scott-whitworth/bancroft_temperature_control/supplementaryData/2021_diagnostic_data/README.md

# Diagnostic Data
Collected summer of 2021 to capture the performance metrics of the system.  

### Heating profiles for full tanks
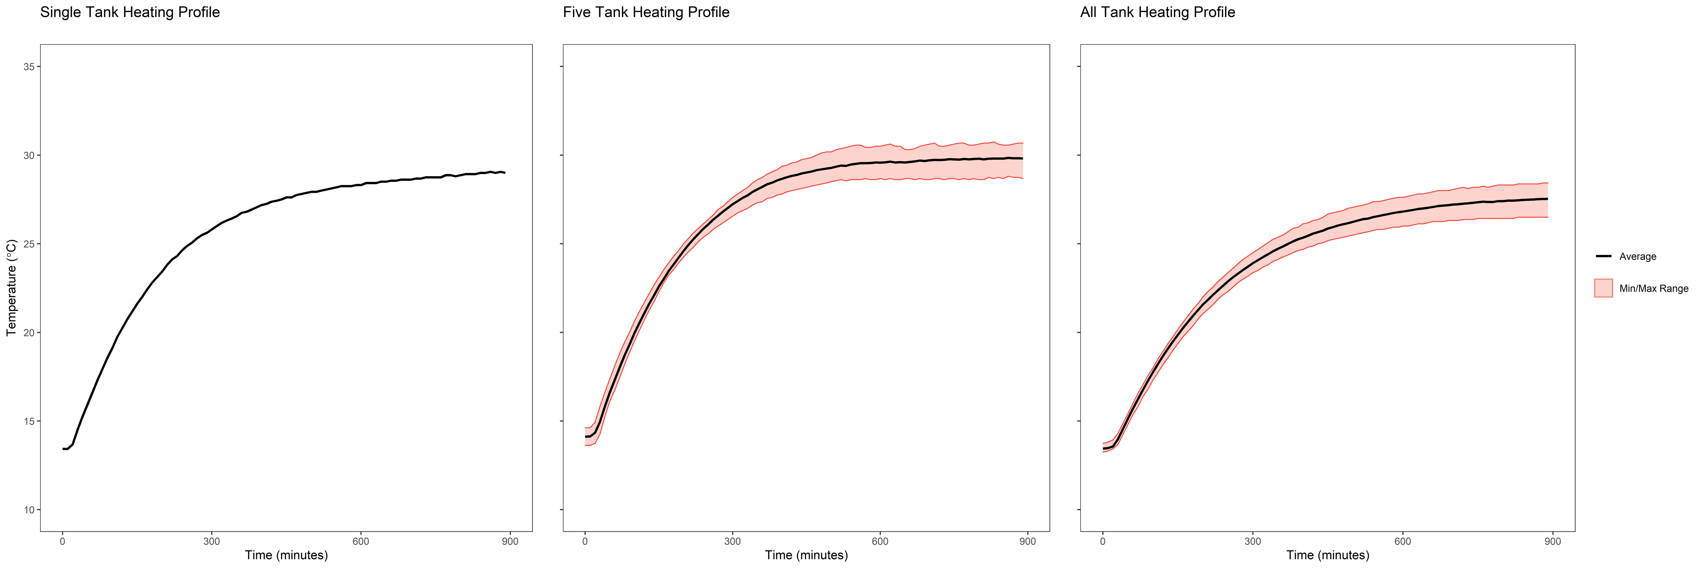
[picture p2: supplementaryData/2021_diagnostic_data/plots/mega_fullTanks__all.png]
ThreeGroup_plot_fullWater

### Heating profiles for half tanks
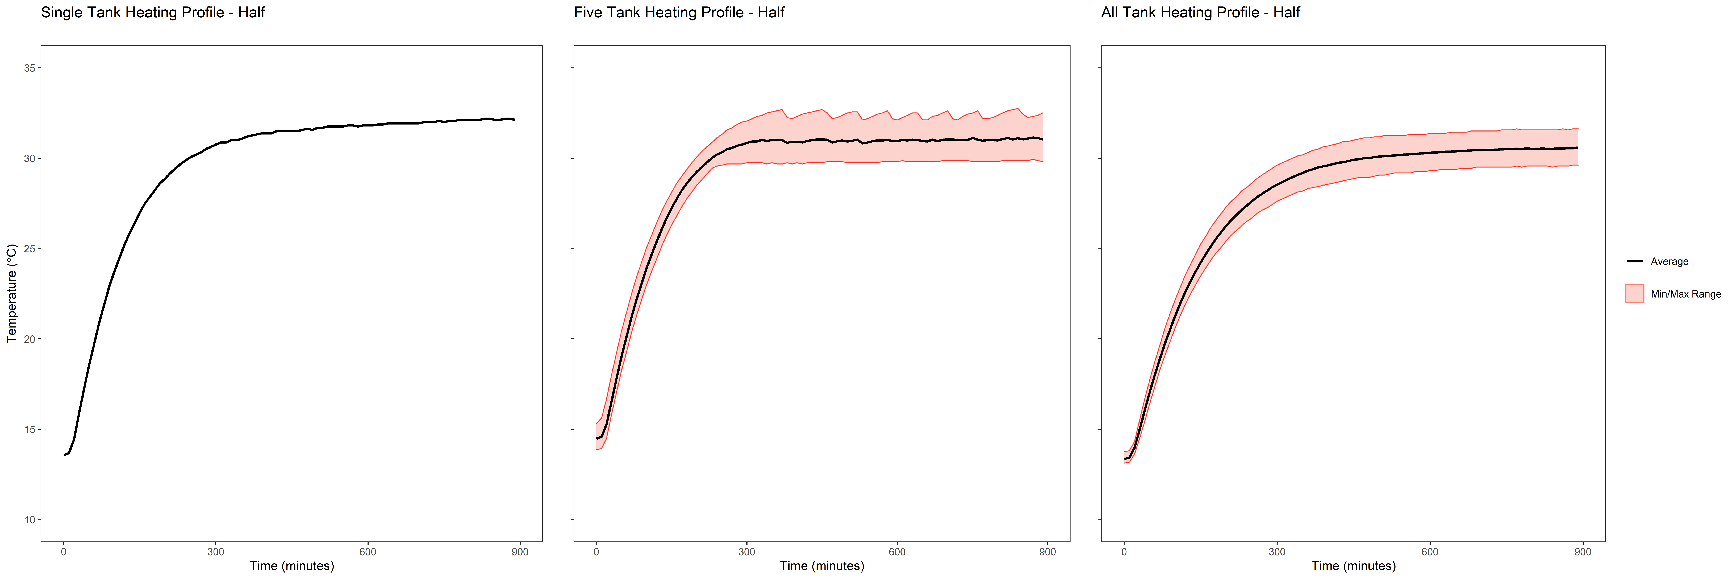
[picture p3: supplementaryData/2021_diagnostic_data/plots/mega_halfTanks__all.png]
ThreeGroup_plot_halfWater
 

## Setup
Each of these data collections were performed on the same 9.4L tanks over the course of two weeks. The goal was to capture approximate performance of the heating system looking at the heating performance when one, five or all nine tanks were heating, as well as the cooling performance. Heating refers to a set temp of 40 degrees C, cooling refers to settling down to the room's ambient (14 degrees C).

In place of using the full system infrastructure, only one Raspberry Pi / Arduino pair was used, without the need to interface with the main control node (Shia). This singular control pair utilized the `peanut_butter_falcon.py` script to collect the data.

Nine tanks were setup in a representative layout, three side by side on each shelf of the rack. There may be some interesting thermal interactions between the tanks. Tanks on a given shelf were spaced by about 2-4 inches separating on their longest side. This means the 'middle' tank was surrounded above, bellow and on each of its larger surface area sides, leaving only the smallest surfaces exposed. This potential thermal interaction can be seen in the individual tanks in `full_one_c2h`.

Tank layout:  

    -------------------------------
    | Tank 73 | Tank 74 | Tank 75 |
    -------------------------------
    | Tank 76 | Tank 77 | Tank 78 |
    -------------------------------
    | Tank 79 | Tank 80 | Tank 81 |
    -------------------------------

## Performance Runs
As the normal experimental set up of the system often modulates the water level in the tanks to represent hydroperiod these performance collections were performed with tanks at both full water levels (~9.4L) as well as half-water levels. As might be expected, the half full tanks heated up faster.  

Another important factor in the performance was the duty cycling of the heaters to limit peak power. When all 9 heaters were 'turned on' the control arduino would apply a sliding window to make sure that only 5 heaters were on at a given time. This means that the per-tank performance is impacted depending on if one tank is heating up, up to five tanks are heating up, or all nine tanks are heating up.

### Full Water Level

| Run | Location | Plot |
|-----|---|---|
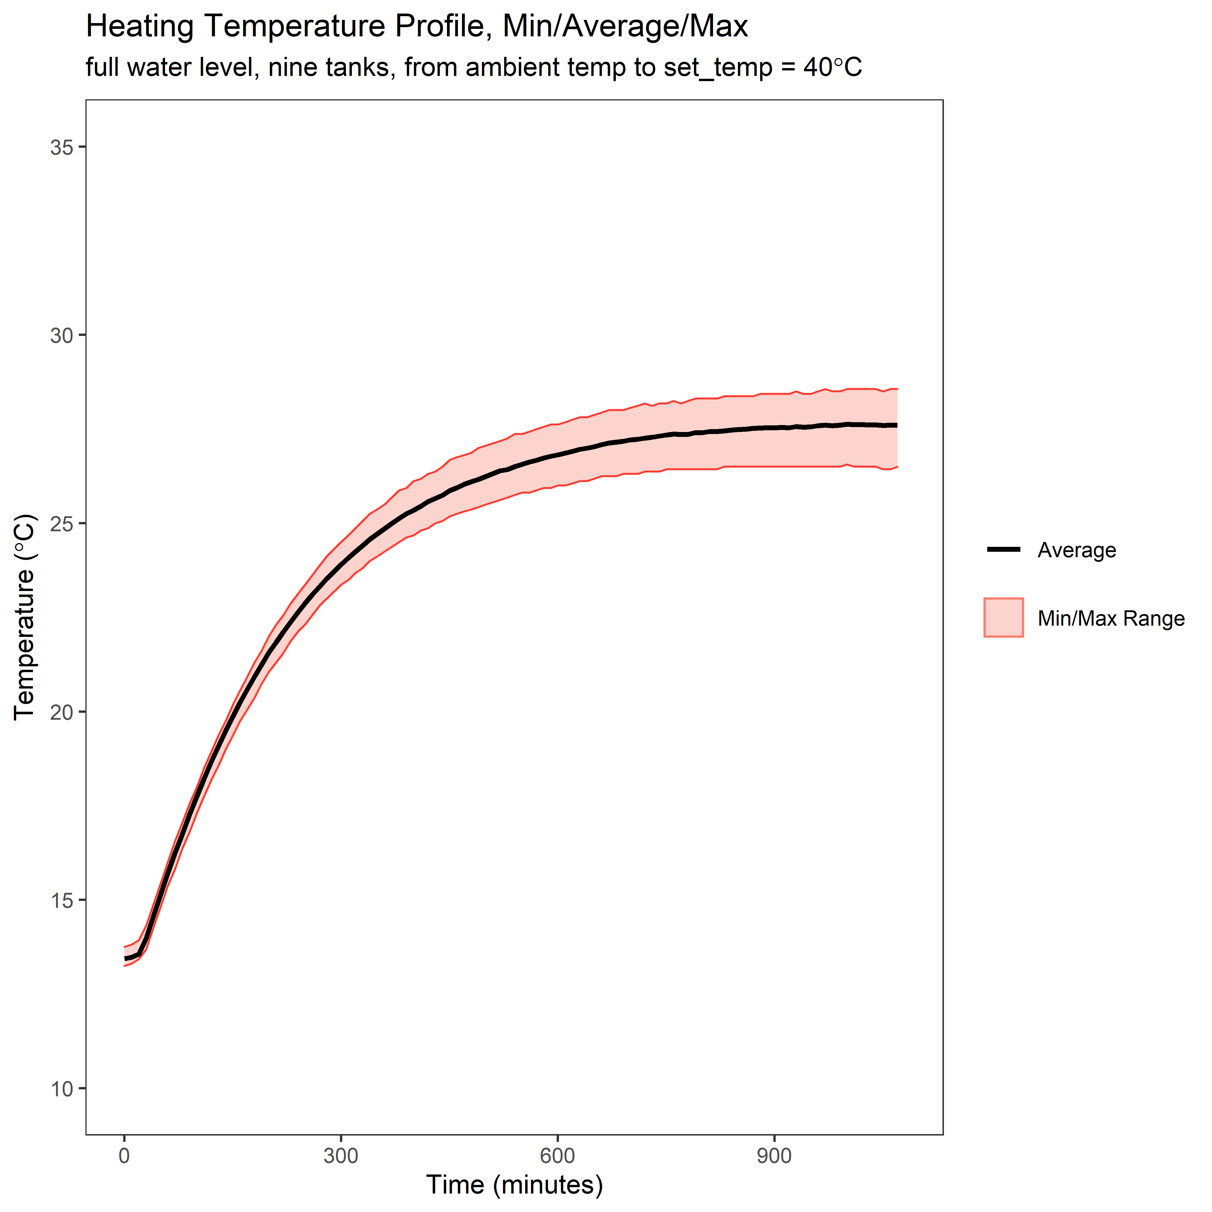
[picture p4: supplementaryData/2021_diagnostic_data/plots/full_all_c2h/full_all_c2h_stat_profile.png]
FullWater_All_Heating
| All Heating | `./plots/full_all_c2h/` |  |
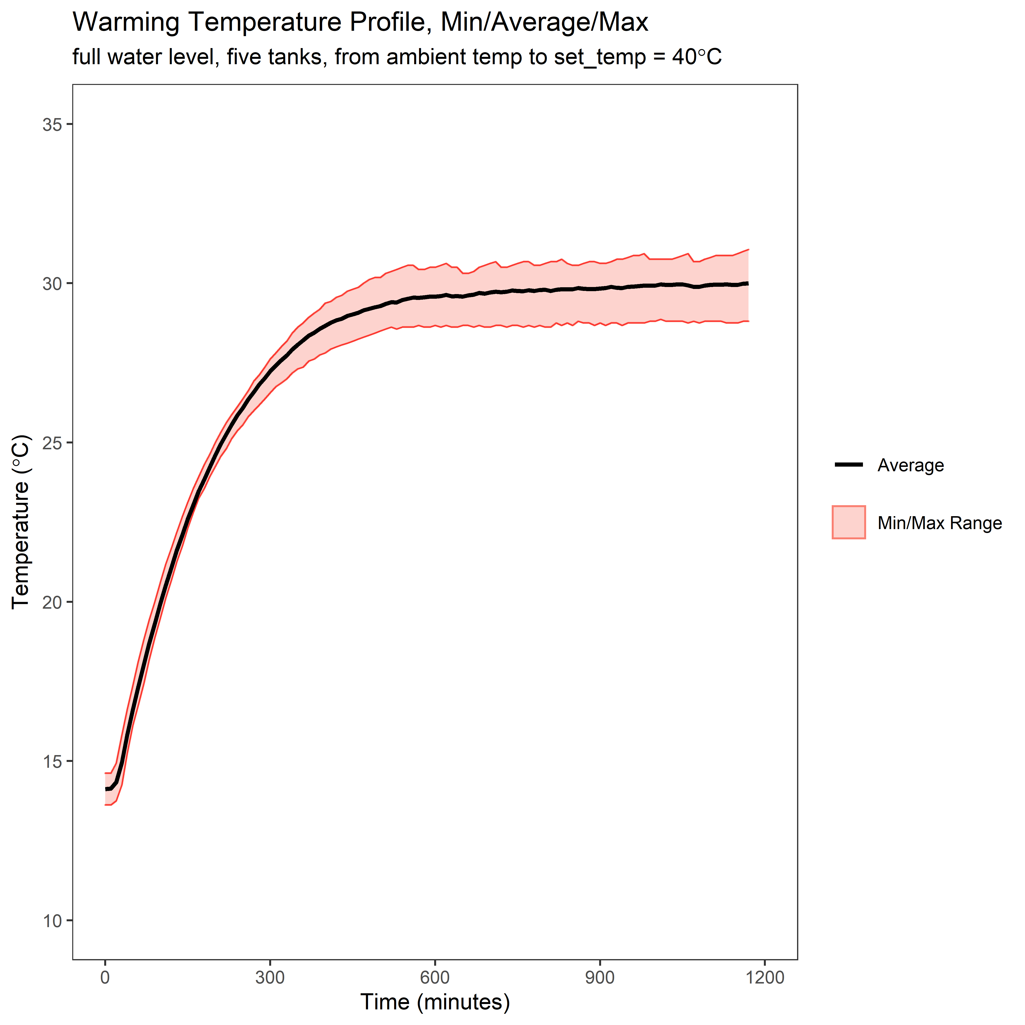
[picture p5: supplementaryData/2021_diagnostic_data/plots/full_five_c2h/full_five_c2h_stat_profile.png]
FullWater_Five_Heating
| Five Heating | `./plots/full_five_c2h/` |  |
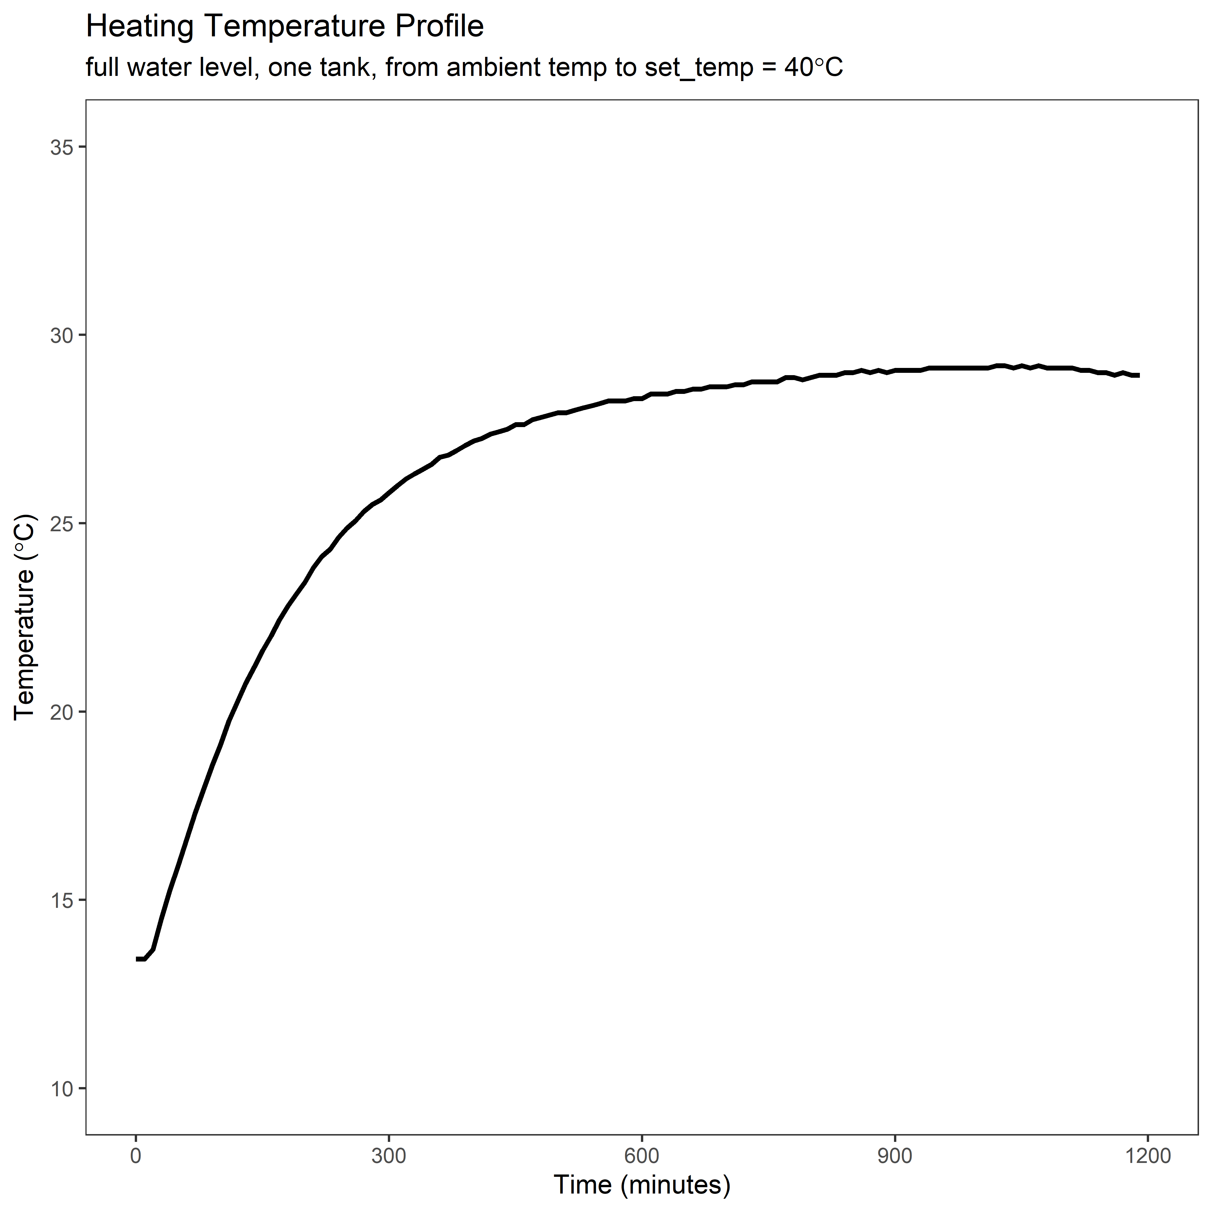
[picture p6: supplementaryData/2021_diagnostic_data/plots/full_one_c2h/full_one_c2h_stat_profile.png]
FullWater_one_Heating
| One Heating | `./plots/full_one_c2h/` |  |
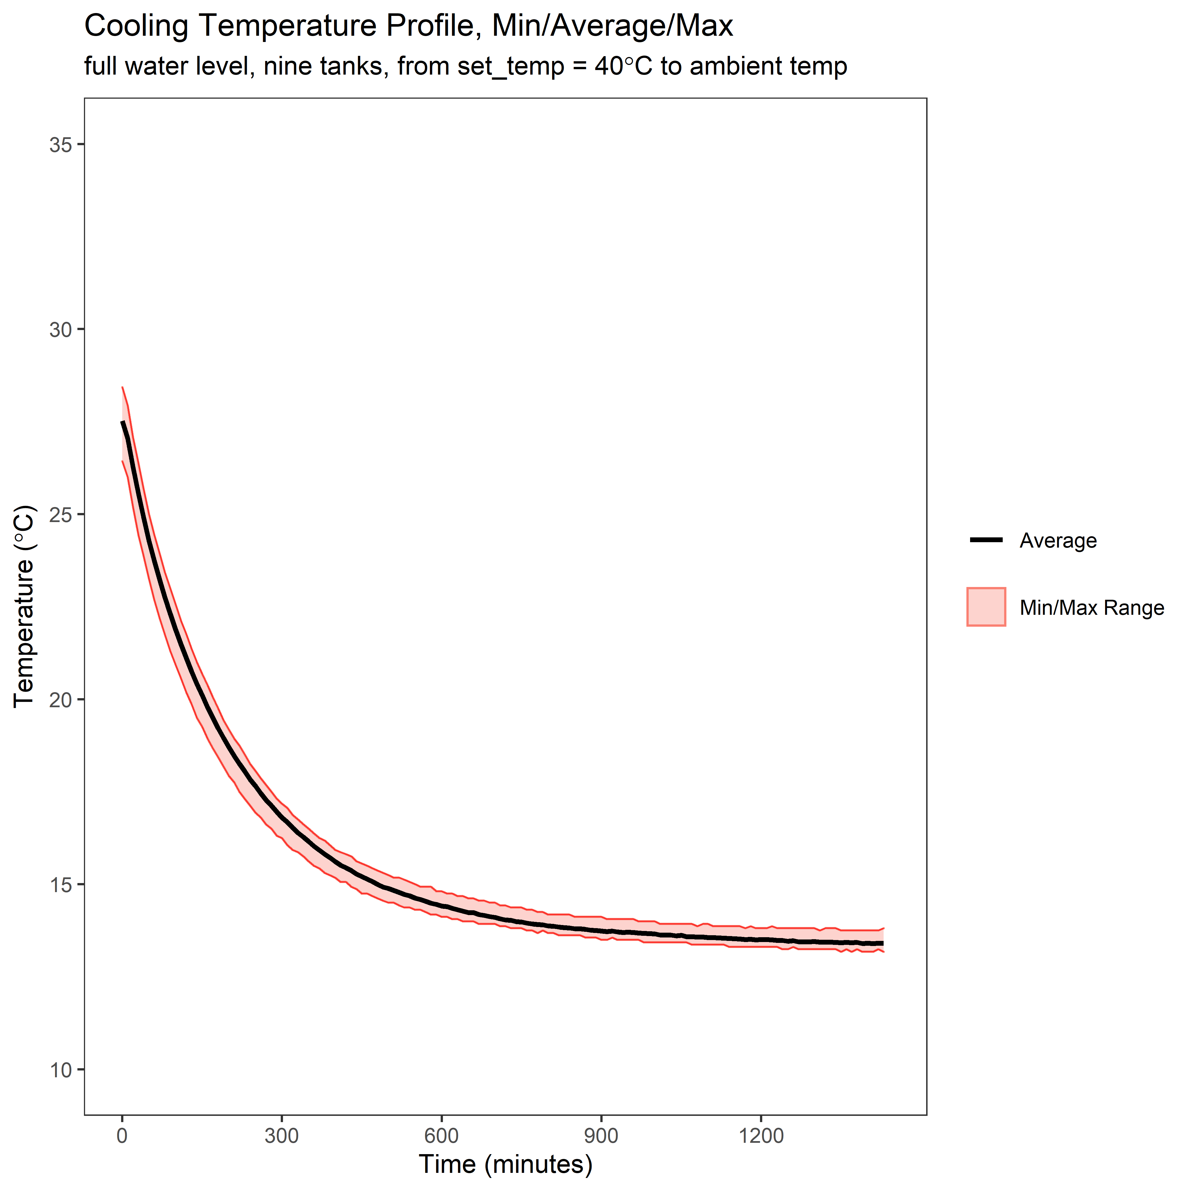
[picture p7: supplementaryData/2021_diagnostic_data/plots/full_all_h2c/full_all_h2c_stat_profile.png]
FullWater_all_Cooling
| All Cooling | `./plots/full_all_h2c/` |  |

### Half Water Level
| Run | Location | Plot |
|-----|---|---|
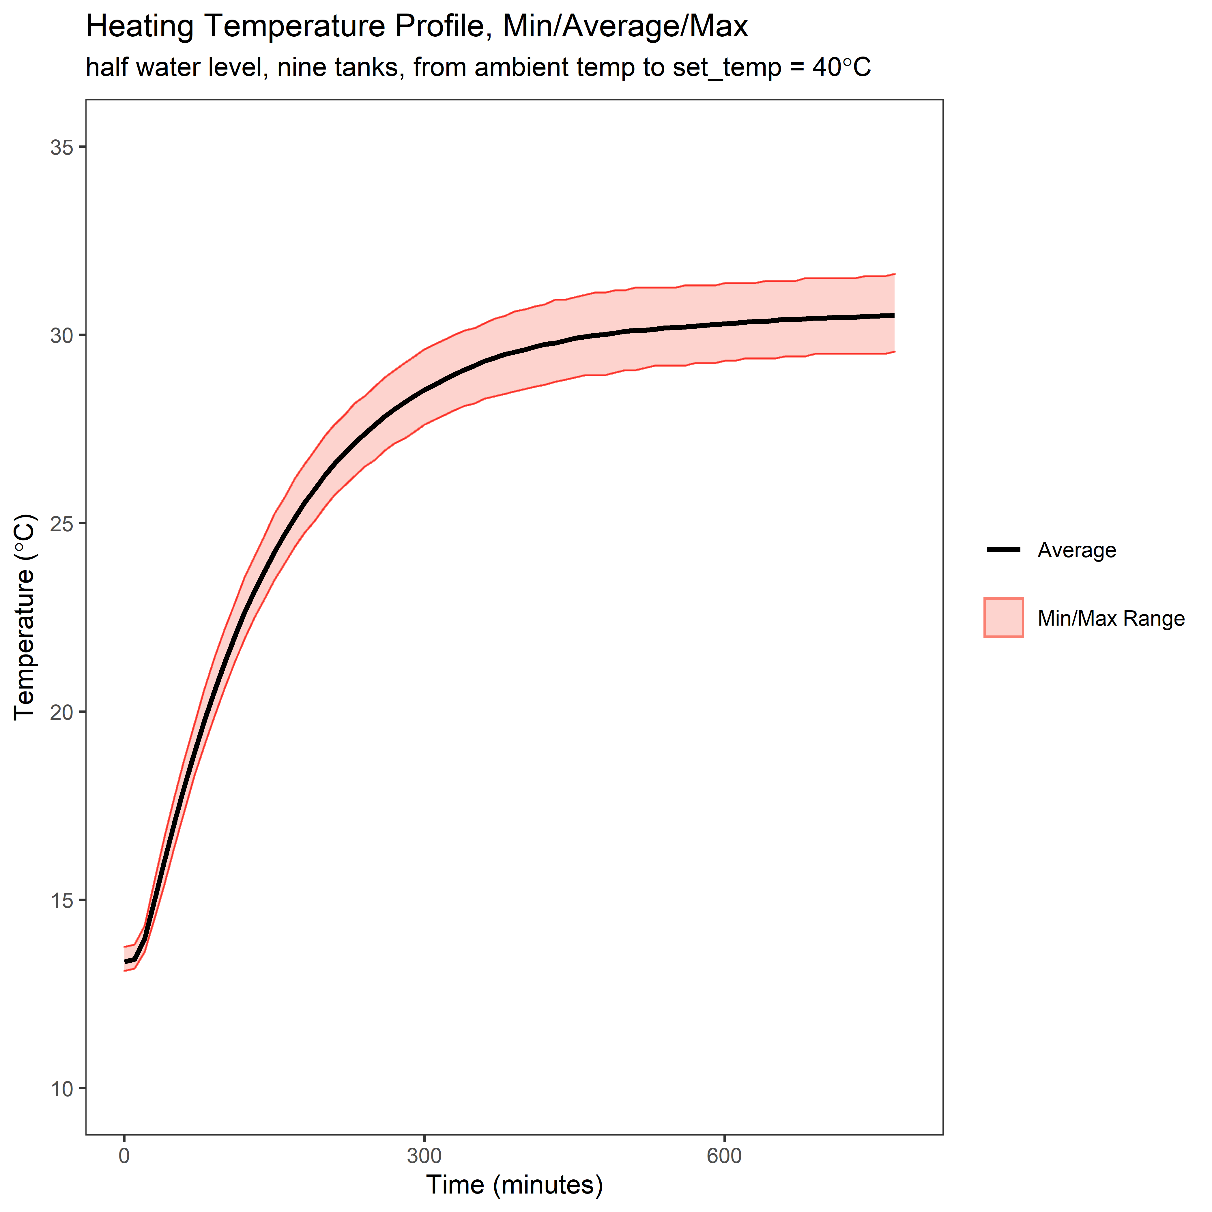
[picture p8: supplementaryData/2021_diagnostic_data/plots/half_all_c2h/half_all_c2h_stat_profile.png]
halfWater_All_Heating
| All Heating | `./plots/half_all_c2h/` |  |
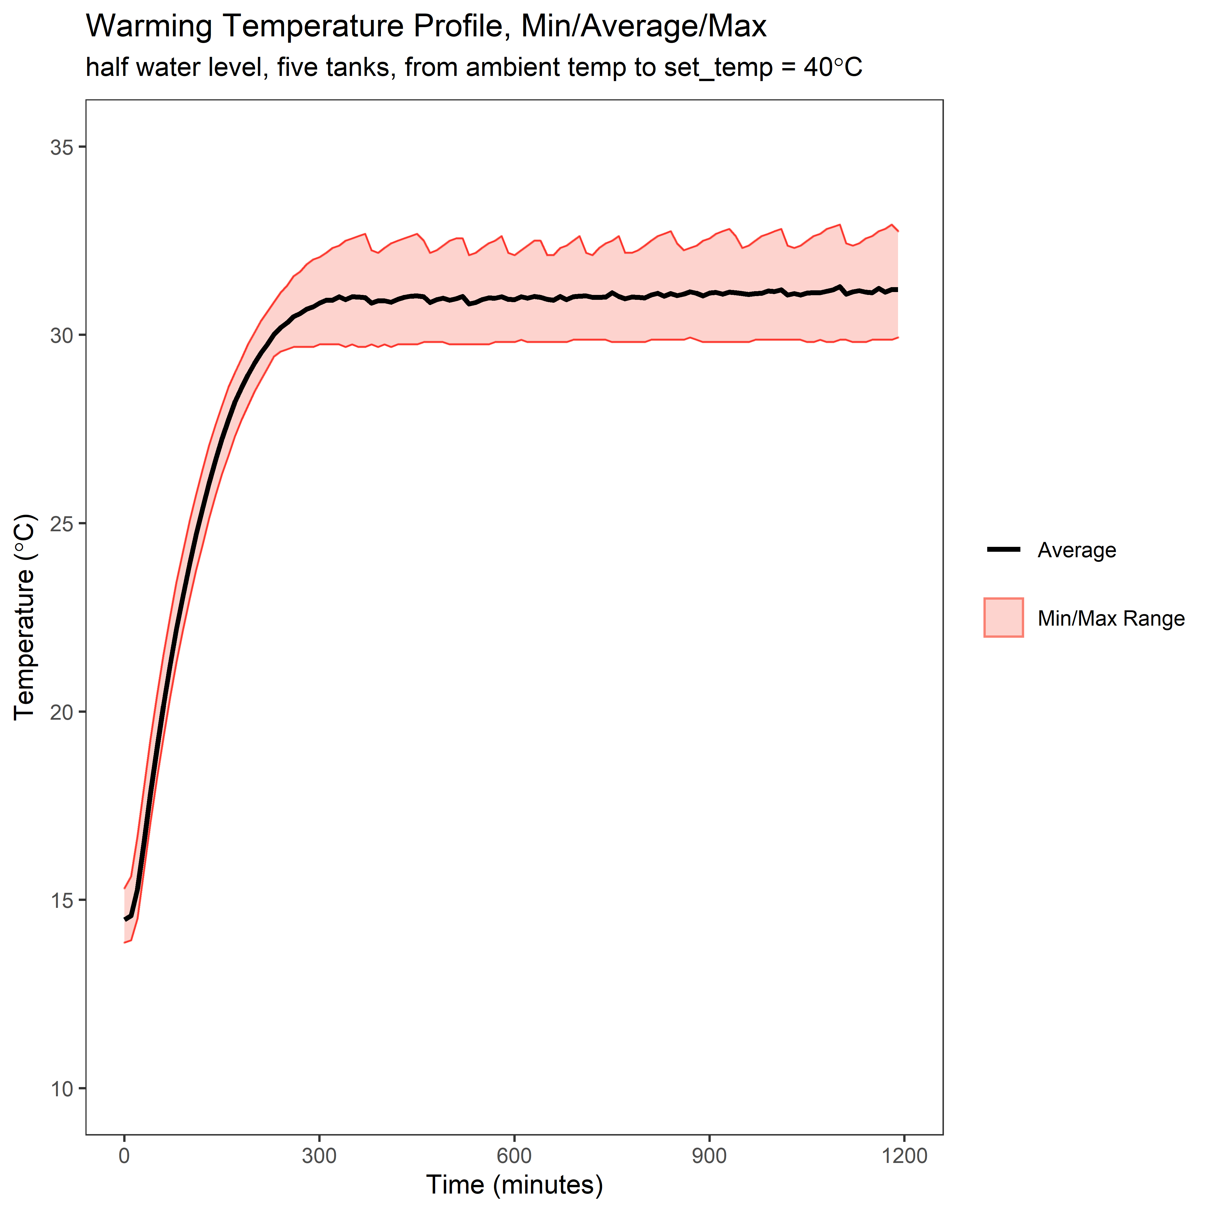
[picture p9: supplementaryData/2021_diagnostic_data/plots/half_five_c2h/half_five_c2h_stat_profile.png]
halfWater_Five_Heating
| Five Heating | `./plots/half_five_c2h/` |  |
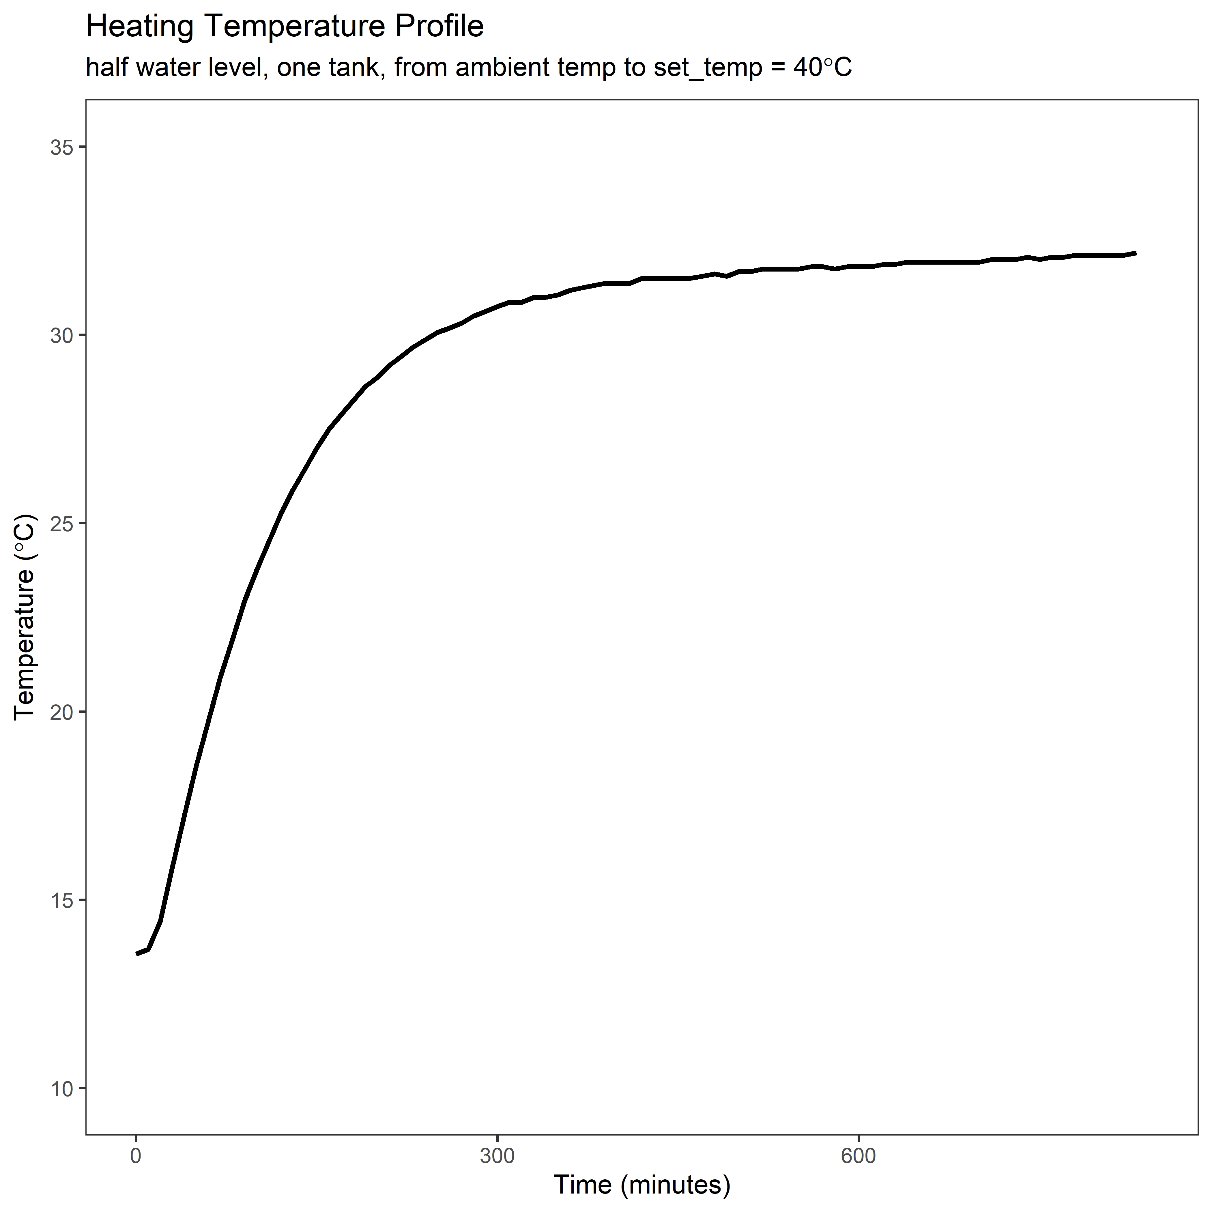
[picture p10: supplementaryData/2021_diagnostic_data/plots/half_one_c2h/half_one_c2h_stat_profile.png]
halfWater_one_Heating
| One Heating | `./plots/full_one_c2h/` |  |
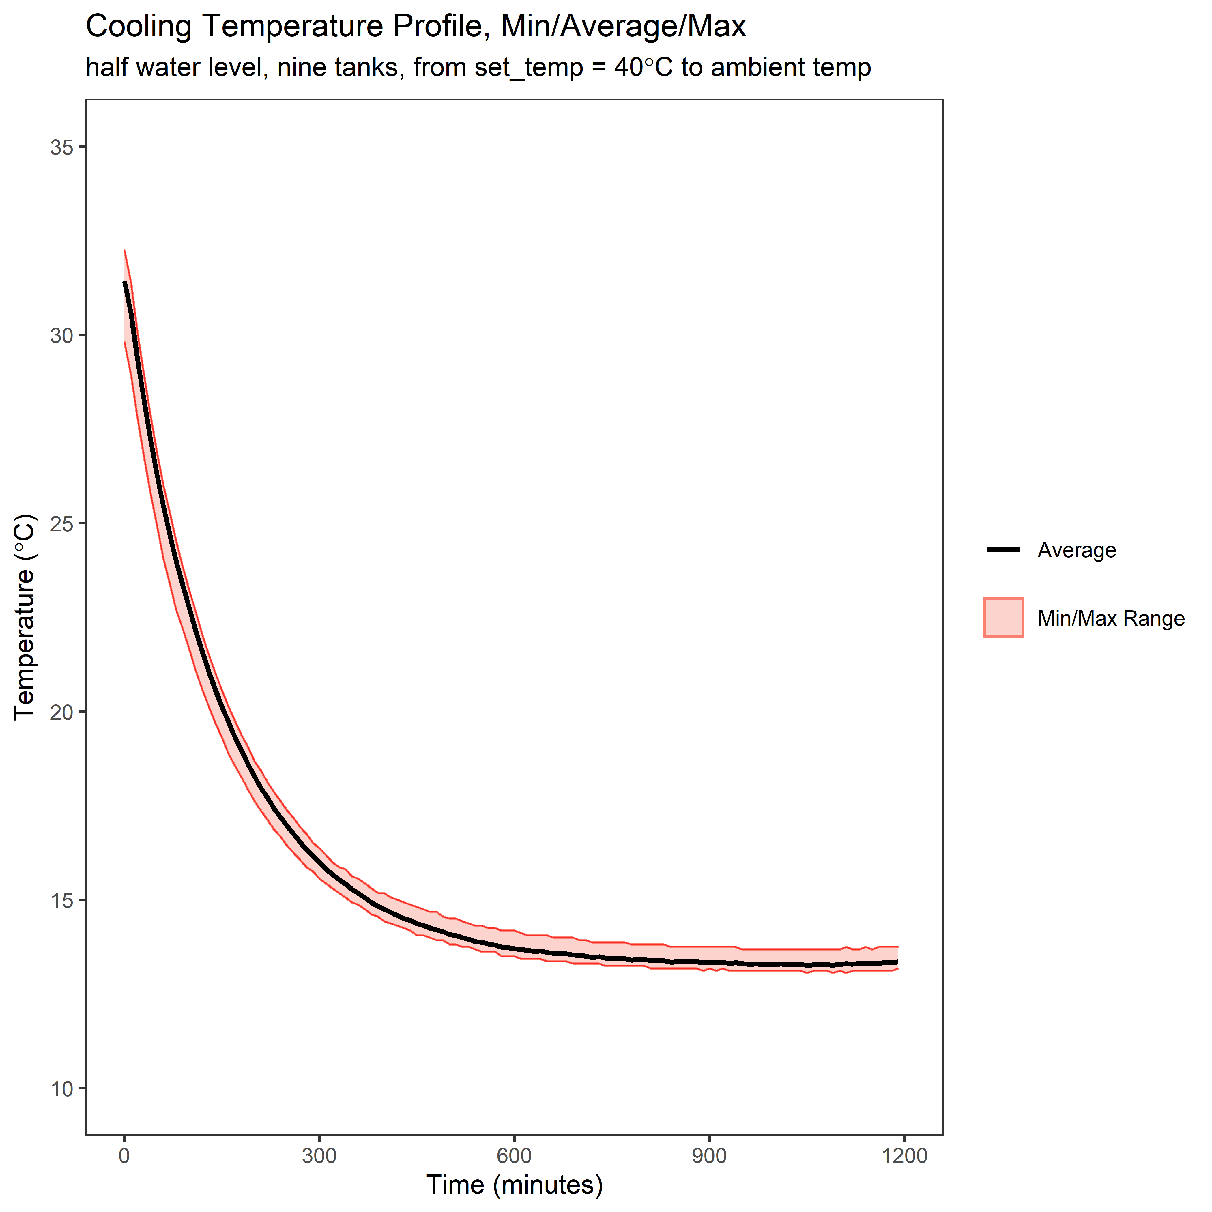
[picture p11: supplementaryData/2021_diagnostic_data/plots/half_all_h2c/half_all_h2c_stat_profile.png]
halfWater_all_Cooling
| All Cooling | `./plots/full_all_h2c/` |  |

## R Scripts and Raw Data
The R scripts used to process these graphs is included as well inside subdirectories.

## Gradient Measurements
Some of the data collected, and outlined in [pbf_notes.md](./pbf_notes.md), was meant to capture the intra-tank heat metrics of the heater and the control temperature probe. These data turned out to be overly dense and visualizing meaningful metrics from them was prohibitively complicated. As interpreting the outcomes of the measurements seemed dubious, graphs were not deemed necessary for this detail of data.

An experimental diagnostic set up was implemented to attempt to collect the performance of the heater as a function of physical space in the tanks. A single tank was outfitted with all nine temperature probes for a given control pair. One probe was used as the control probe, the others were used to collect gradient data across the tank. As a reference the two images [gradient_iso_7_2021.jpg](gradient_iso_7_2021.jpg) and [gradient_profile_7_2021.jpg](gradient_profile_7_2021.jpg) give a visual representation of the temperature probe fixture described in the notes file. During the collection of the data, the set temp for the control node was ether 39.9°C (above the thermal cutoff of the heaters, so above max temp) or 6°C (below the ambient temperature, so min temp).

When the tank was experiencing sustained warming (going from no heat, to max heat), when the control probe read 15.56°C (which by design is set up farthest from the heater in the tank, and is in the period of the highest heat change), the rest of the temperature probes read a higher temperature. The highest read temperature was 17.87°C from the probe directly above the heater, with the average error being +1.6°C relative to the control probe. Over the course of heating the tank to max temperature the highest difference from the control probe was +2.5°C, Average was +0.5°C, Median was 1.88°C. The probes closest to the heater were consistently +1.5-2°C higher than the control. This might have to do with the nature of the test, this would require the heater to be on 100% of the time. This would produce a constant temperature gradient between the heater and the cooler room temperature. We expect that this gradient would not be as drastic given the normal operation of the heater cycling on/off to maintain a lower set-temp.

# Temperature Metrics

From 15% to 85% of total range. This ignores the extremes of the profiles. It should also be noted that the resolution of the temperature probes is about 0.36 degrees.  

| Heating / Cooling | Number of Tanks | Full / Half Water Level | Min/Max/\[Average\] Delta ( $C\degree/hour$ ) | Relevant File |  
|---|---|---|---|---|
| Heating | One tank | Half water | 0.72 / 8.28 / **3.40** | `pbf_2021_7_6_one_tank_heating_half_water` |
| Heating | One tank | Full water | 0.36 / 4.14 / **1.78** | `pbf_2021_7_9_one_tank_cold_to_hot_full_tanks.csv` |
| Heating | Five tanks | Half water | 1.86 / 8.22 / **4.91** | `pbf_2021_7_9_one_tank_cold_to_hot_full_tanks.csv` |
| Heating | Five tanks | Full water | 0.72 / 4.92 / **2.51** | `pbf_2021_7_12_five_tanks_warming_full_water.csv` |
| Heating | All tanks  | Half water | 1.5 / 7.08 / **3.21** | `pbf_2021_6_30_cold_to_hot_all_half.csv` |
| Heating | All tanks  | Full water | 0.36 / 3.72 / **1.70** | `pbf_2021_7_14_all_cold_to_hot_full_tank.csv` |
| Cooling | All tanks  | Half water | -0.72 / -7.5 / **-2.91** | `pbf_2021_6_29_hot_to_cold_halfTank.csv` |
| Cooling | All tanks  | Full water | -0.36 / -4.5 / **-1.57** | `pbf_2021_7_15_hot_to_cold_full_tank.csv` |
