scott-whitworth/bancroft_temperature_control/supplementaryData/2018_Temperature_Profiles/Readme.md

# Example Temperature Data
These data sets were utilized for an experiment summer of 2018. They represent the experimental design of the temperature requirements for the experiment.

* `historic_data_6_26_18.csv` represents a nominal temperature profile of a pond in the Eastern Washington region over the summer months.
* `Future_30min_increment_rpi_2017_06_123.csv` represents a calculated potential future temperature profile of similar ponds, but with the impacts of climate change
