scott-whitworth/bancroft_temperature_control/supplementaryData/2021_diagnostic_data/gradient_profile_7_2021.jpg

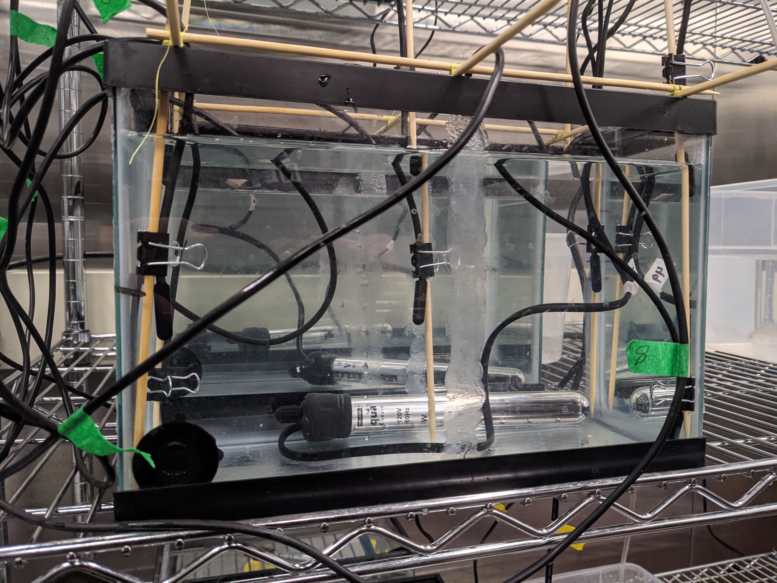
supplementaryData/2021_diagnostic_data/gradient_profile_7_2021.jpg
