scott-whitworth/bancroft_temperature_control/supplementaryData/2021_diagnostic_data/plots/full_all_c2h/full_all_c2h_79_tank_single.png

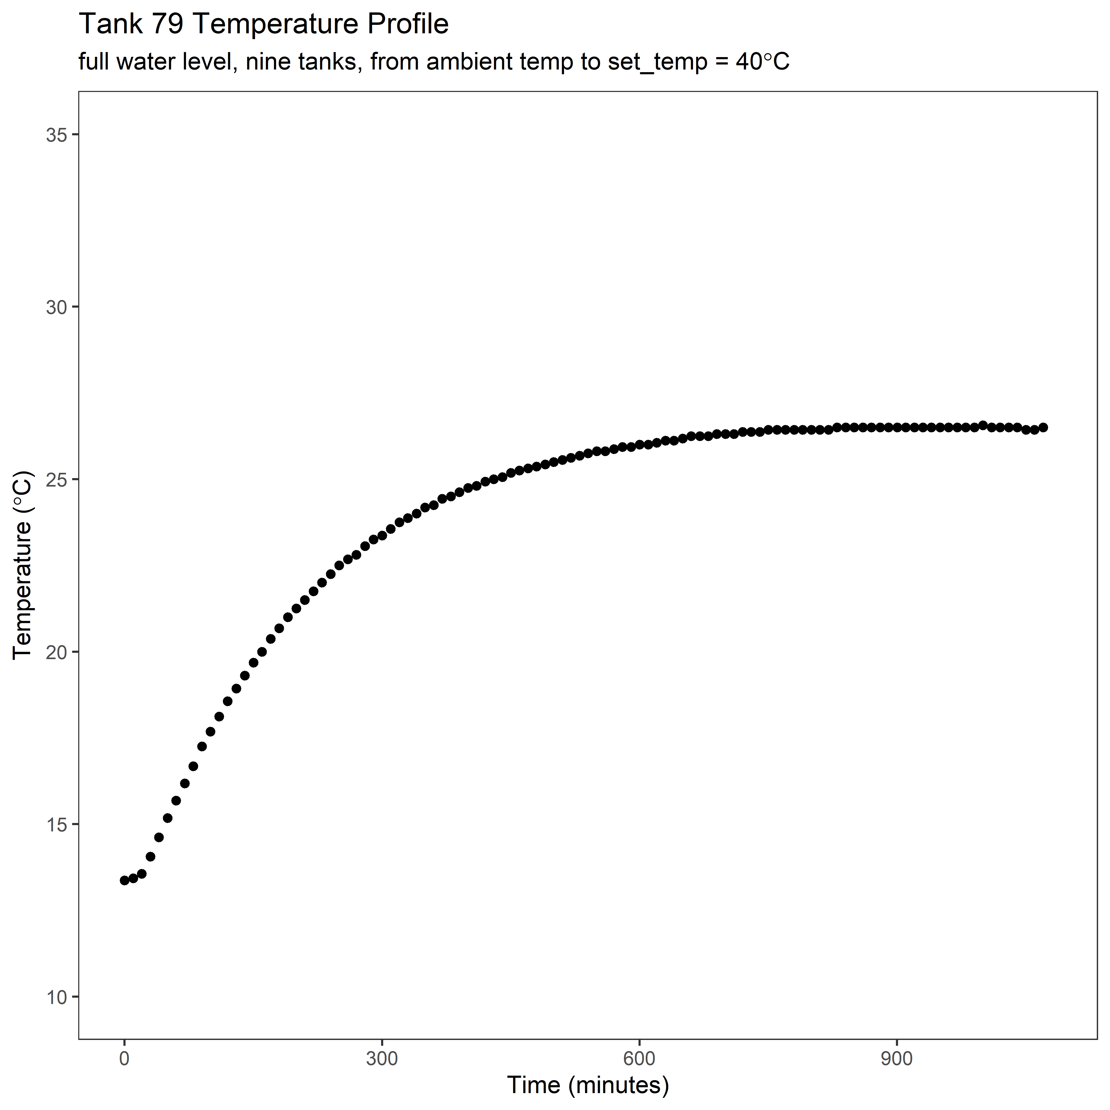
supplementaryData/2021_diagnostic_data/plots/full_all_c2h/full_all_c2h_79_tank_single.png
