scott-whitworth/bancroft_temperature_control/supplementaryData/2021_diagnostic_data/plots/full_all_h2c/full_all_h2c_76_tank_single.png

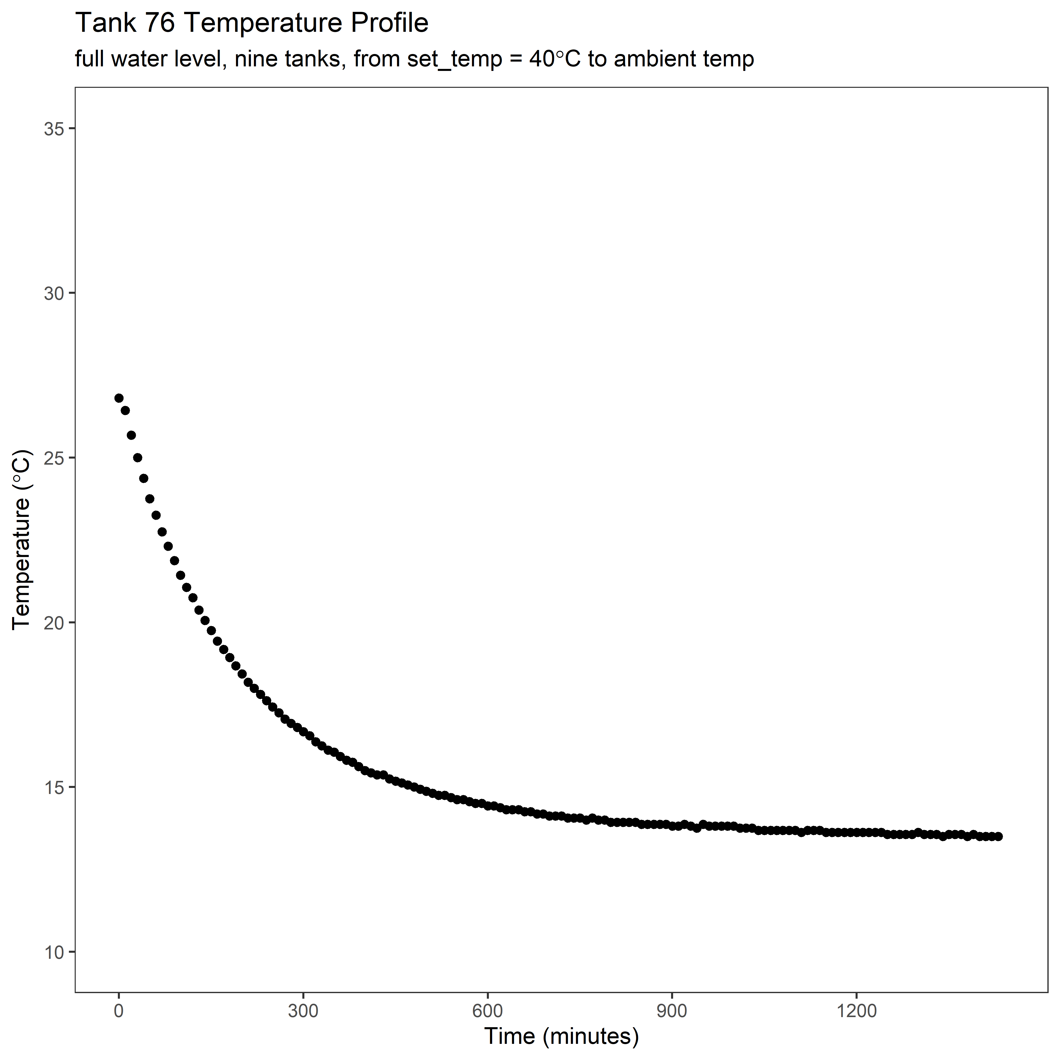
supplementaryData/2021_diagnostic_data/plots/full_all_h2c/full_all_h2c_76_tank_single.png
