scott-whitworth/bancroft_temperature_control/supplementaryData/2021_diagnostic_data/plots/full_five_c2h/full_five_c2h_81_tank_single.png

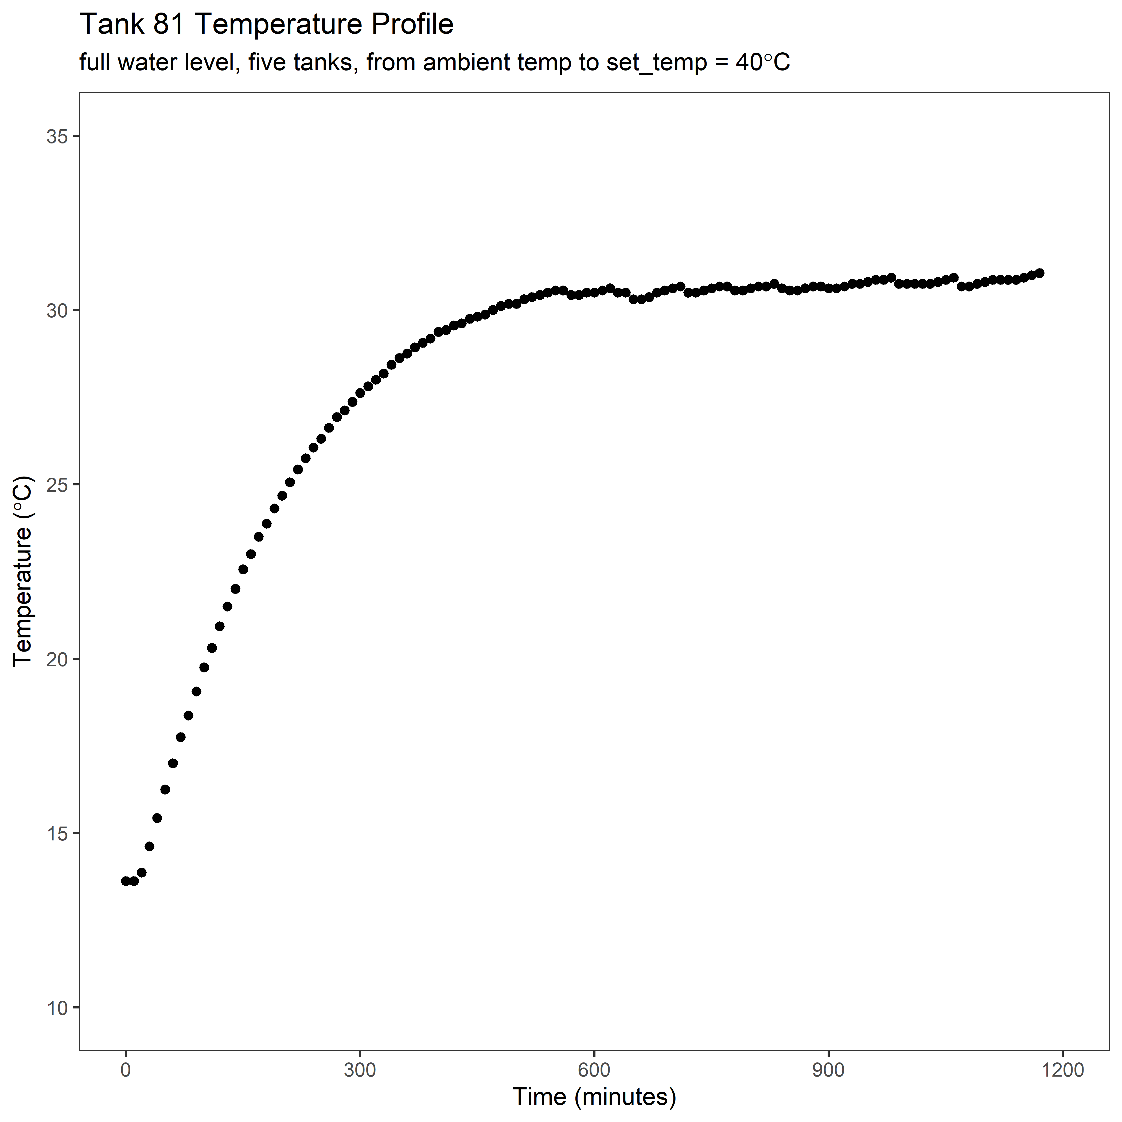
supplementaryData/2021_diagnostic_data/plots/full_five_c2h/full_five_c2h_81_tank_single.png
