scott-whitworth/bancroft_temperature_control/supplementaryData/2021_diagnostic_data/plots/full_one_c2h/full_one_c2h_73_tank_single.png

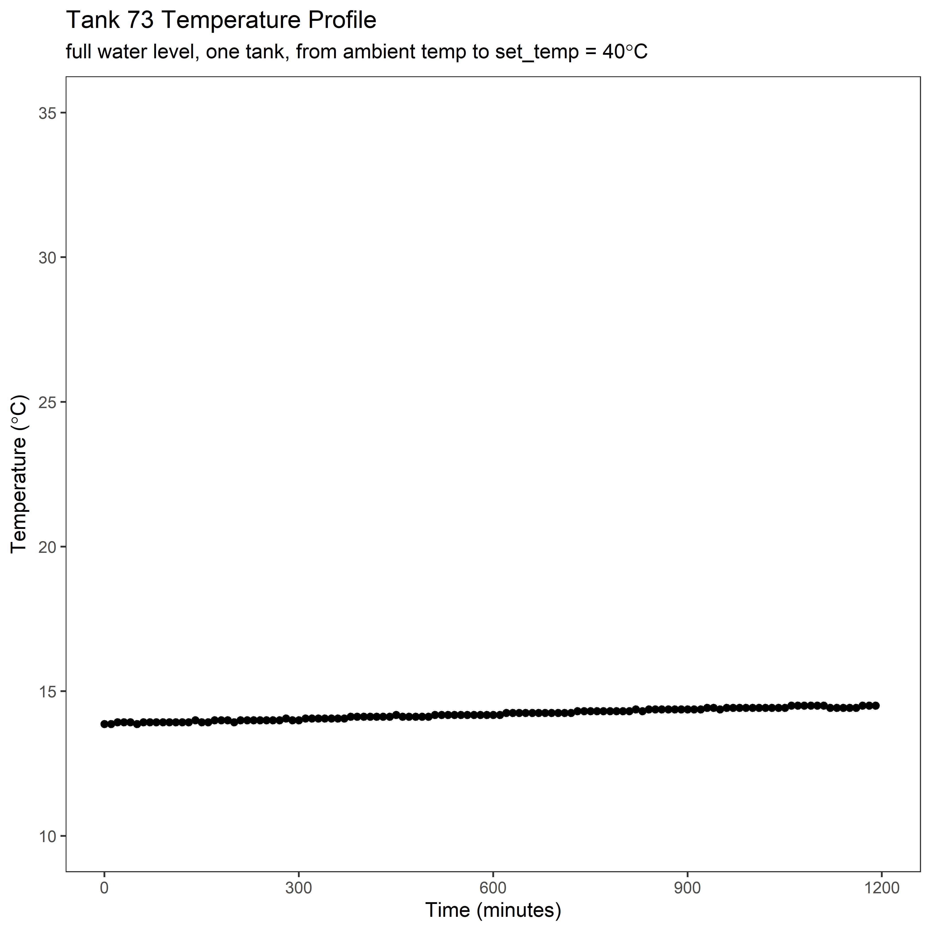
supplementaryData/2021_diagnostic_data/plots/full_one_c2h/full_one_c2h_73_tank_single.png
