scott-whitworth/bancroft_temperature_control/supplementaryData/2021_diagnostic_data/plots/half_all_c2h/half_all_c2h_74_tank_single.png

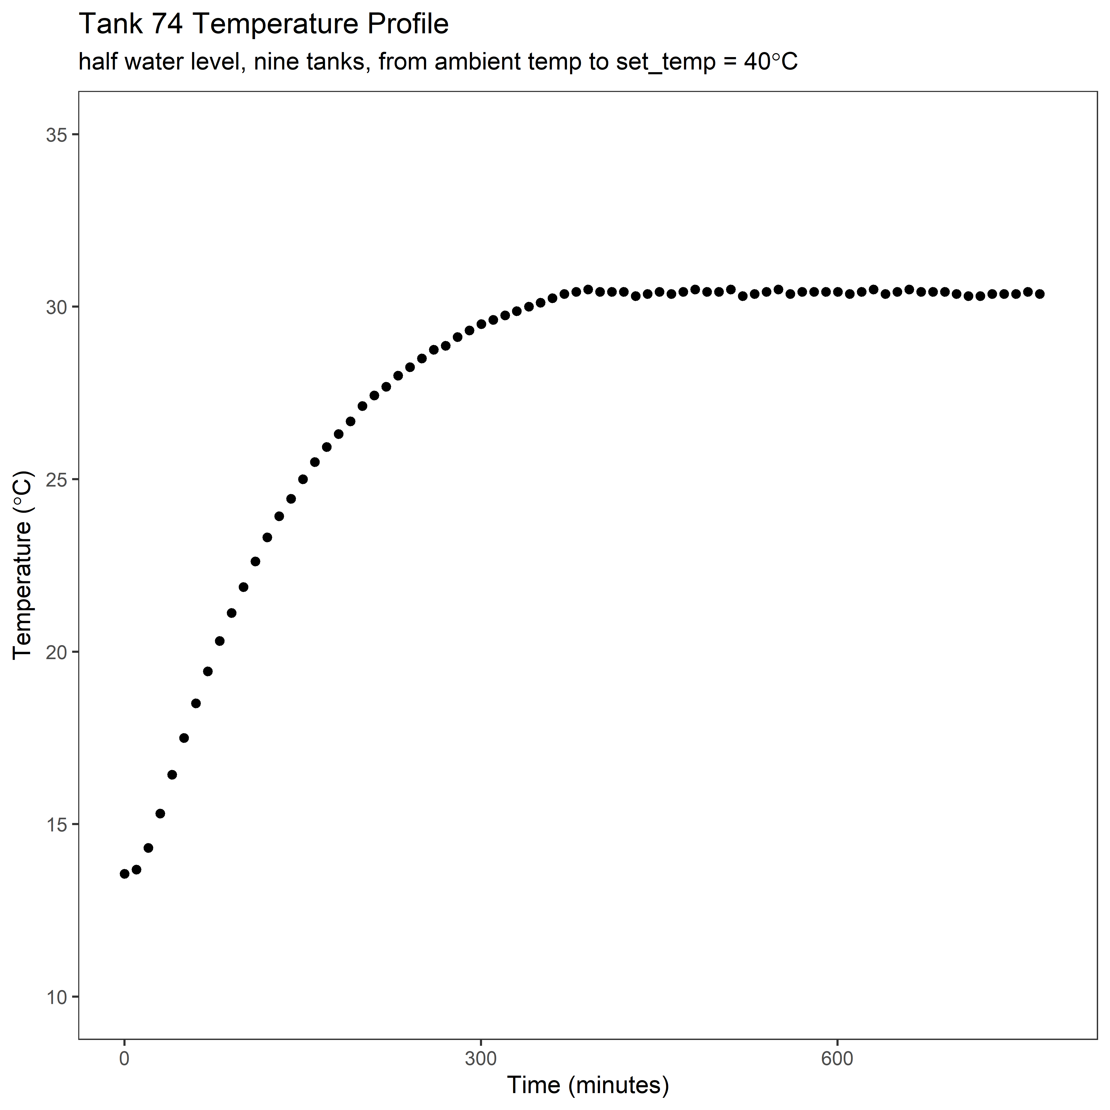
supplementaryData/2021_diagnostic_data/plots/half_all_c2h/half_all_c2h_74_tank_single.png
