scott-whitworth/bancroft_temperature_control/supplementaryData/2021_diagnostic_data/plots/half_all_h2c/half_all_h2c_73_tank_single.png

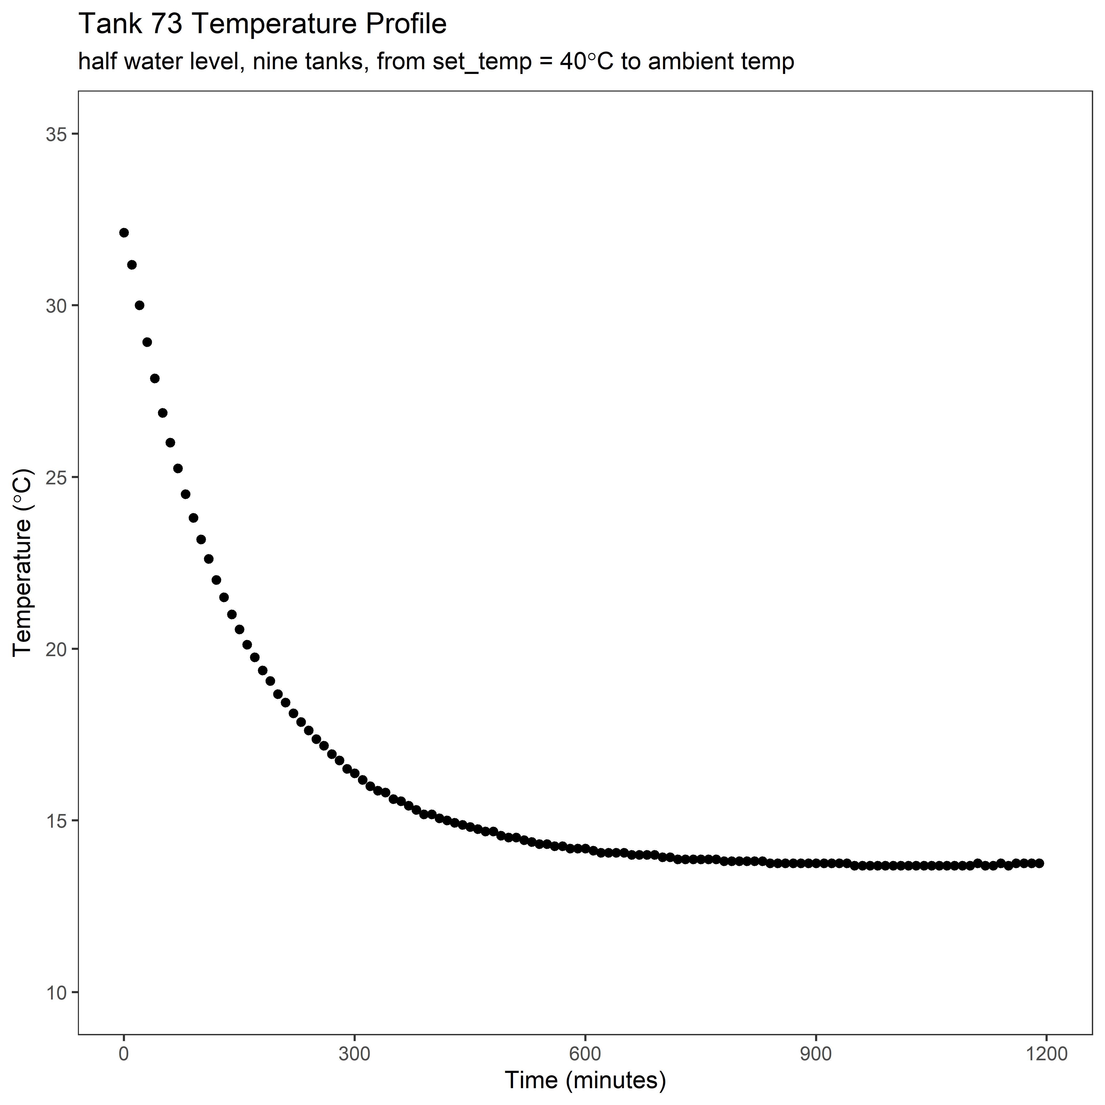
supplementaryData/2021_diagnostic_data/plots/half_all_h2c/half_all_h2c_73_tank_single.png
