scott-whitworth/bancroft_temperature_control/supplementaryData/2021_Experimental_Data/README.md

# Performance Data from 2021 Experiment
This data was collected in support of other experimental work in Bancroft's Ecology lab over the summer of 2021.

## Data
It should be noted that the experiment started on day 14 (hence the gap in data after day 11).
