scott-whitworth/bancroft_temperature_control/(commit log)

2021-10-10 First push over from protected repo
    [runtimeConfig.txt, runtimeConfig_2019.txt]
2021-10-10 Bill of material
2021-11-09 Added 2021 Diagnostic Data and Charts
    [pbf_2021_6_28_all_warming_half_tanks.csv, pbf_2021_6_29_hot_to_cold_halfTank.csv, pbf_2021_6_30_cold_to_hot_all_half.csv, pbf_2021_7_12_five_cold_to_hot_full_tank.csv, pbf_2021_7_12_five_tanks_warming_full_water.csv, pbf_2021_7_13_cool_down_full_tank.csv, pbf_2021_7_14_all_cold_to_hot_full_tank.csv, pbf_2021_7_15_hot_to_cold_full_tank.csv]
2021-12-17 Temp Profile Examples
    [Future_30min_increment_rpi_2017_06_123.csv, historic_data_6_26_18.csv]
2022-12-05 Dalke et al 2023 supplementary data
    [Dalke et al 2023 FWS data.xlsx]
