scott-whitworth/bancroft_temperature_control/supplementaryData/System_Photos/arduino_breakout_detail.jpg

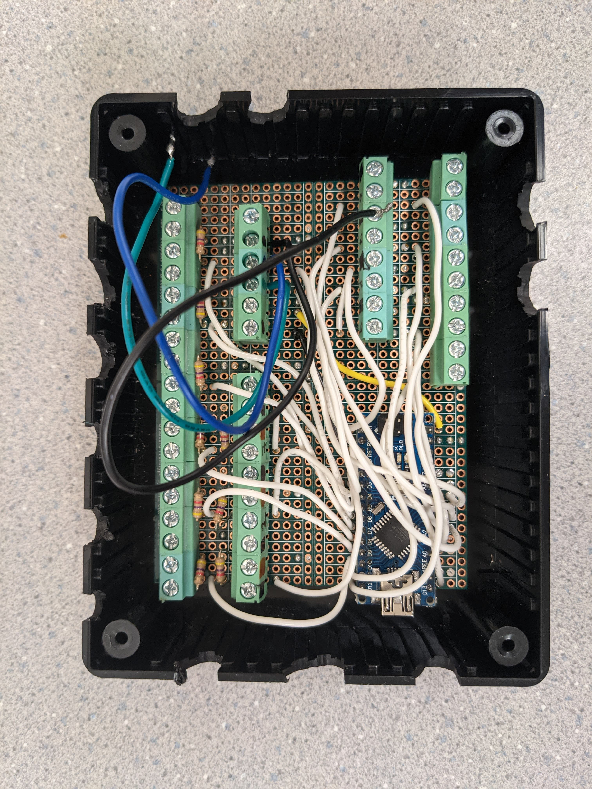
[picture p22: supplementaryData/System_Photos/arduino_breakout_detail.jpg]
supplementaryData/System_Photos/arduino_breakout_detail.jpg
