scott-whitworth/bancroft_temperature_control/supplementaryData/System_Photos/arduino_pi_connection.jpg

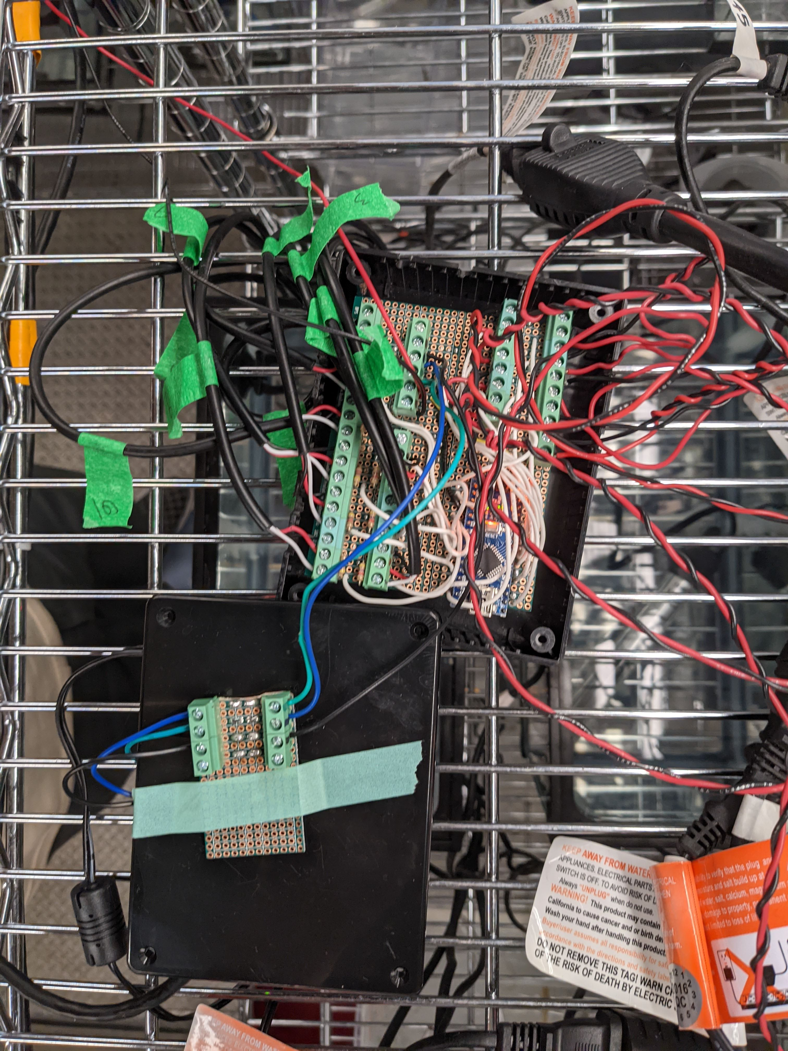
[picture p23: supplementaryData/System_Photos/arduino_pi_connection.jpg]
supplementaryData/System_Photos/arduino_pi_connection.jpg
